mozzwald/A8PicoCart/pcbs/mozzwald-edition/A8PicoCart-mozz_schematic.jpg

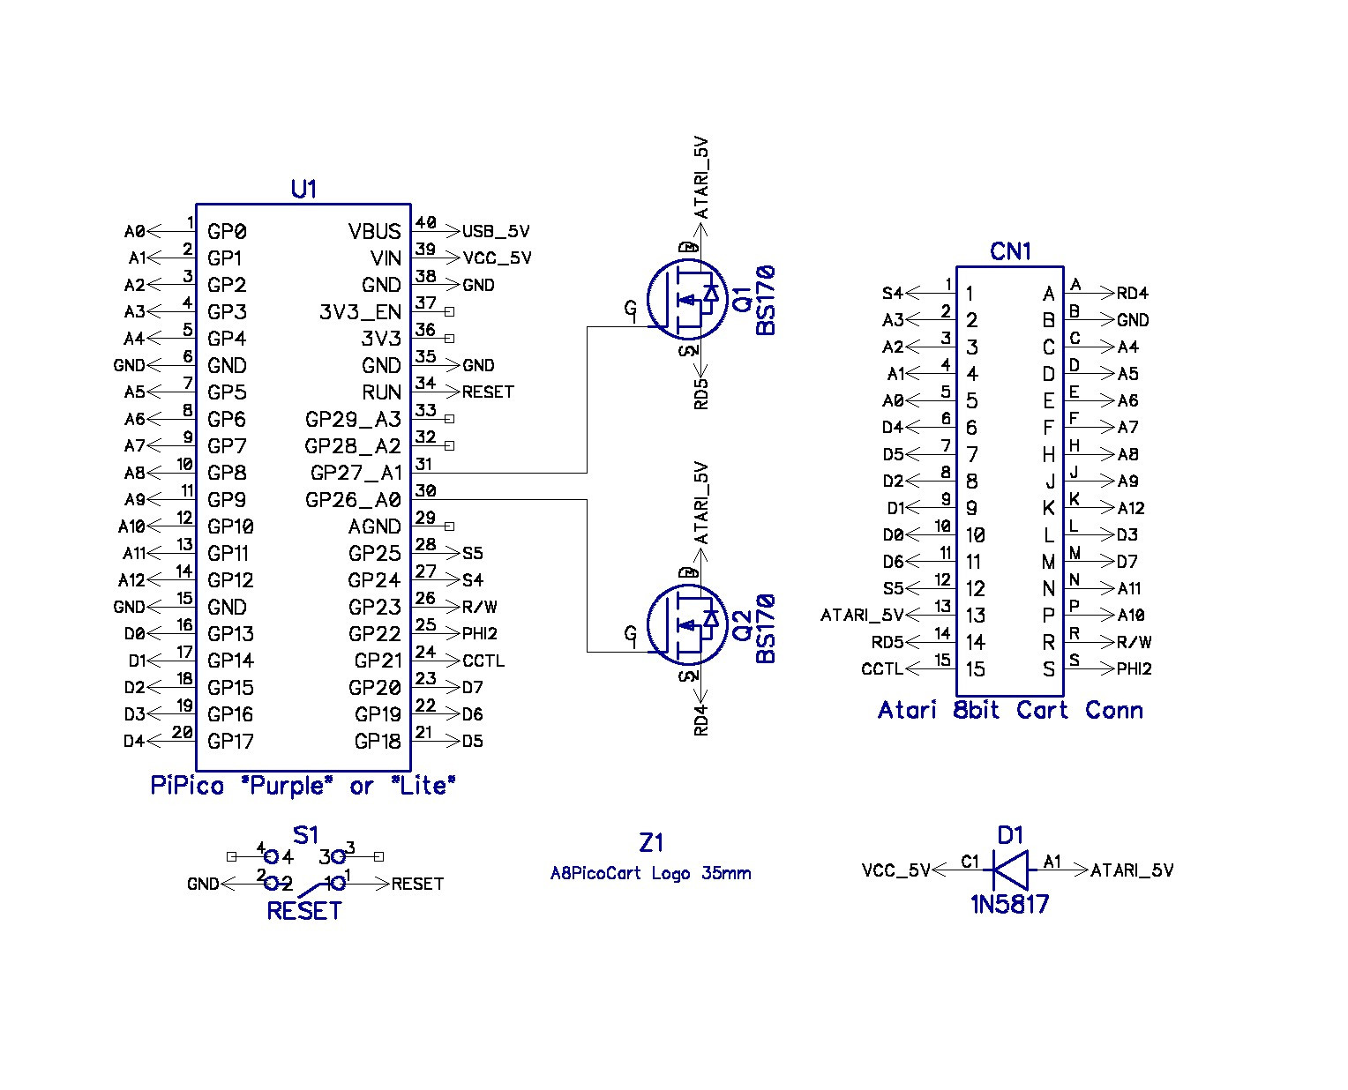
pcbs/mozzwald-edition/A8PicoCart-mozz_schematic.jpg
