mozzwald/A8PicoCart/pcbs/mozzwald-edition/3D/A8PicoCart Edge Sanding Jig.stl

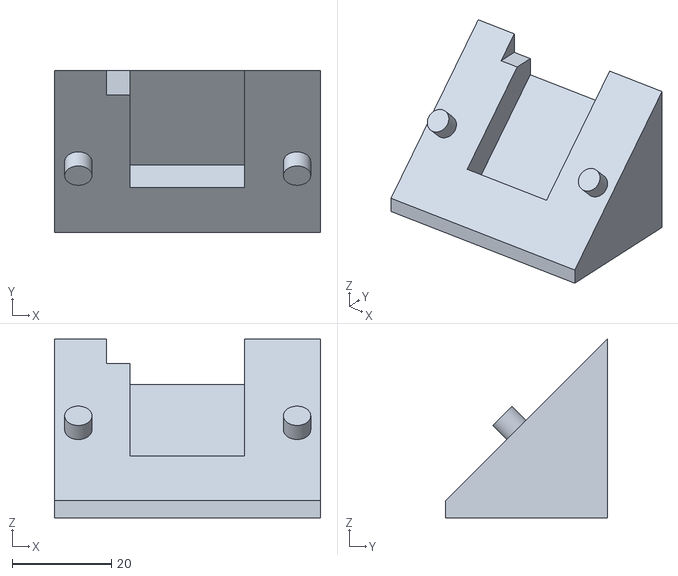
[picture p2: CAD file, 2023-12-03]
pcbs/mozzwald-edition/3D/A8PicoCart Edge Sanding Jig.stl
53.5 x 32.5 x 36.0
