mozzwald/A8PicoCart/pcbs/mozzwald-edition/3D/A8PicoCart-mozz-bootsel-button.stl

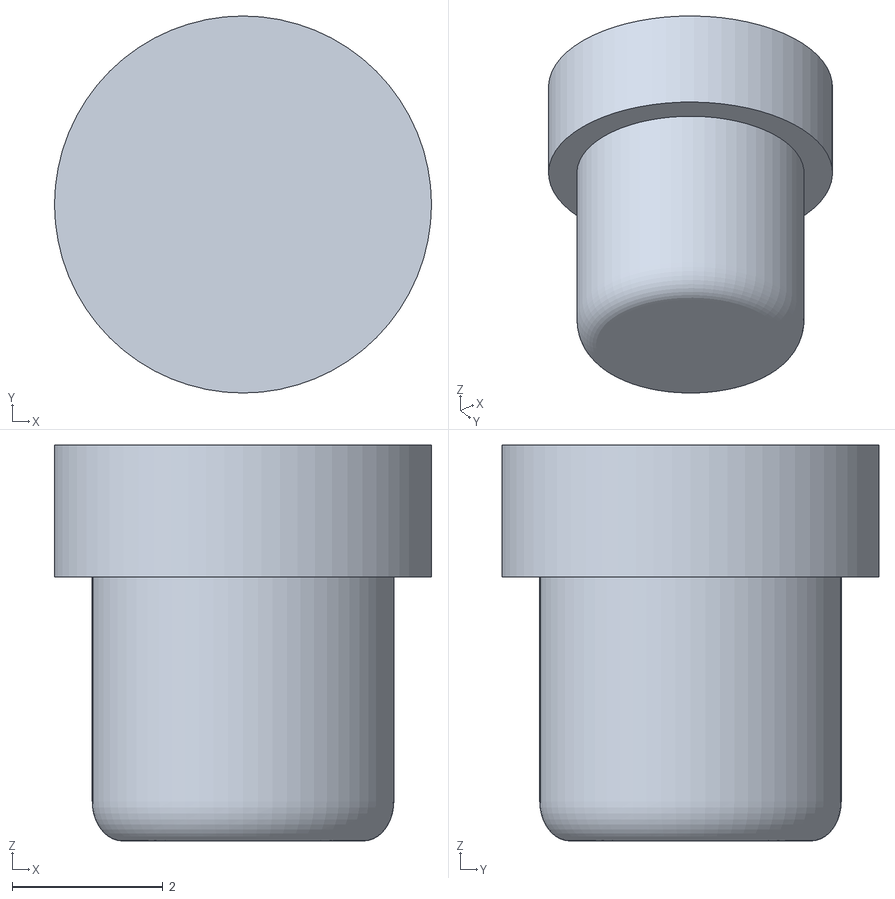
[picture p3: CAD file, 2023-12-03]
pcbs/mozzwald-edition/3D/A8PicoCart-mozz-bootsel-button.stl
5.00 x 5.00 x 5.25
