mozzwald/A8PicoCart/pcbs/mozzwald-edition/3D/A8PicoCart-mozz-logo-inlay.stl

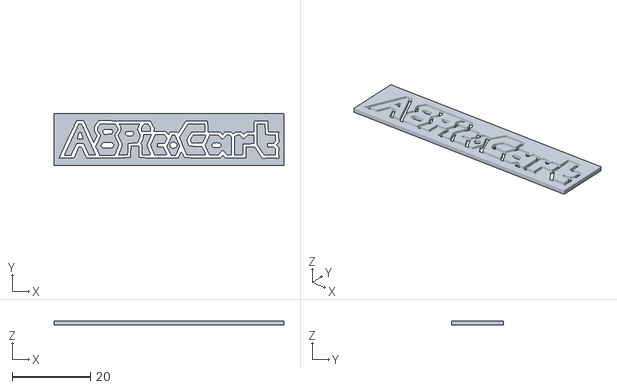
[picture p4: CAD file, 2023-12-03]
pcbs/mozzwald-edition/3D/A8PicoCart-mozz-logo-inlay.stl
58.8 x 13.2 x 1.00
