mozzwald/A8PicoCart/pcbs/mozzwald-edition/3D/A8PicoCart-mozz-front.stl

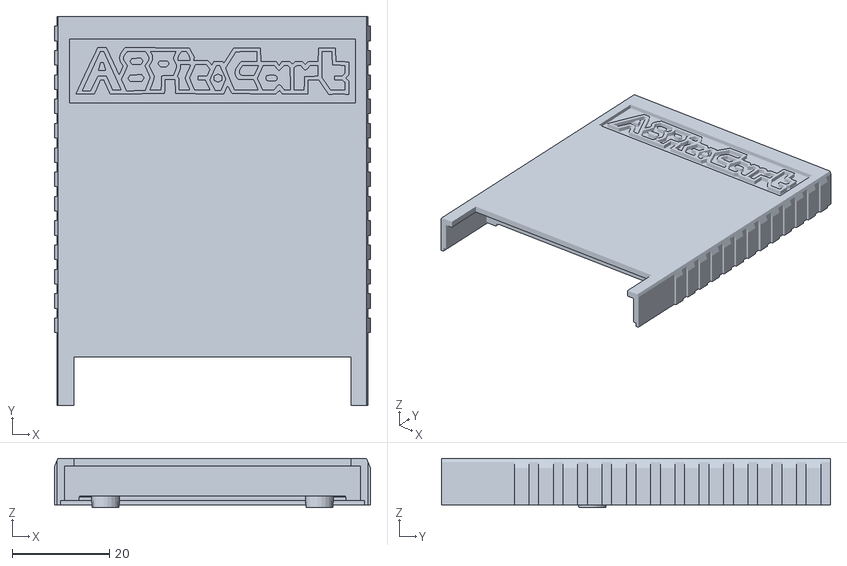
[picture p5: CAD file, 2023-12-03]
pcbs/mozzwald-edition/3D/A8PicoCart-mozz-front.stl
65.0 x 80.0 x 10.1
