mozzwald/A8PicoCart/pcbs/mozzwald-edition/3D/A8PicoCart-mozz-rear.stl

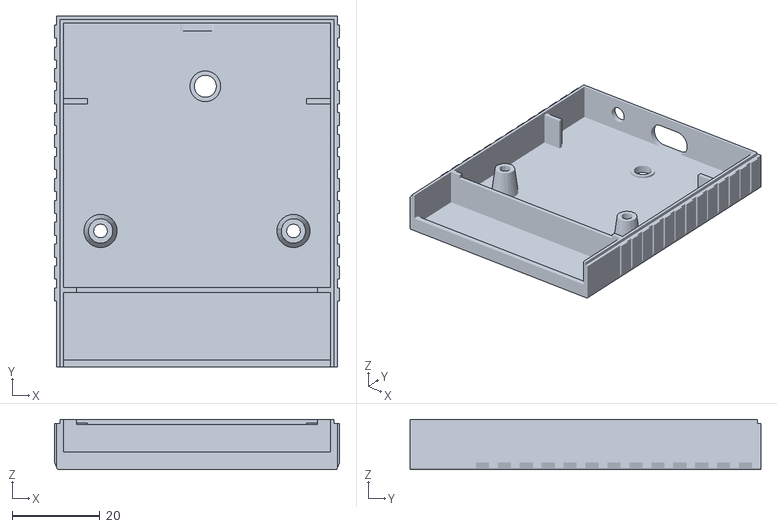
[picture p6: CAD file, 2023-12-03]
pcbs/mozzwald-edition/3D/A8PicoCart-mozz-rear.stl
65.0 x 80.0 x 11.5
