mozzwald/A8PicoCart/(list of files, drawings)

Other design files:
pcbs/mozzwald-edition/A8PicoCart-mozz.dch
pcbs/mozzwald-edition/A8PicoCart-mozz.dip
