mozzwald/A8PicoCart/(commit log)

2023-12-03 Add mozzwald edition PCB and 3D files
    [A8PicoCart-mozz-bootsel-button.stl, A8PicoCart-mozz-front.stl, A8PicoCart-mozz-logo-inlay.stl, A8PicoCart-mozz-rear.stl, A8PicoCart-mozz.dch, A8PicoCart-mozz.dip, A8PicoCart-mozz_BOM.csv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]
2023-12-03 Add PCB sanding jig and update README
    [A8PicoCart Edge Sanding Jig.stl]
2023-12-08 Add FETs to protect RD4 & RD5 lines
    [A8PicoCart-mozz.dch, A8PicoCart-mozz.dip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]
2023-12-10 Update mozz BOM
    [A8PicoCart-mozz_BOM.csv]
